daniel-sudz/pie/docs/Oscilloscope Music 7a3aaad3ab964c1fb35f99a9dc6e4d58/Mechanical Design b92b71b563af48b09839214c2a25bd87/Keyboard Laser Files bfc2a2a59c6f4edcae71e7054d06419a.html

# Keyboard Laser Files

All of these files were cut from 4.9mm thick plywood, except the Top, which was cut from 3.2mm plywood.

Back.dxf

Bottom.dxf

Front.dxf

Left.dxf

Right.dxf

Switch Back.dxf

Switch Left.dxf

Switch Plate.dxf

Top.dxf

The keyboard also includes two 3D printed parts:

Black key.stl

Bracket.stl

You can view the original CAD document for yourself here: https://cad.onshape.com/documents/308a798550238d0f1d9b5cc9/w/01307690bded43323ab41f7d/e/85378917edef5c38c061a6b5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
