daniel-sudz/pie/docs/Oscilloscope Music 7a3aaad3ab964c1fb35f99a9dc6e4d58/Untitled 3.jpeg

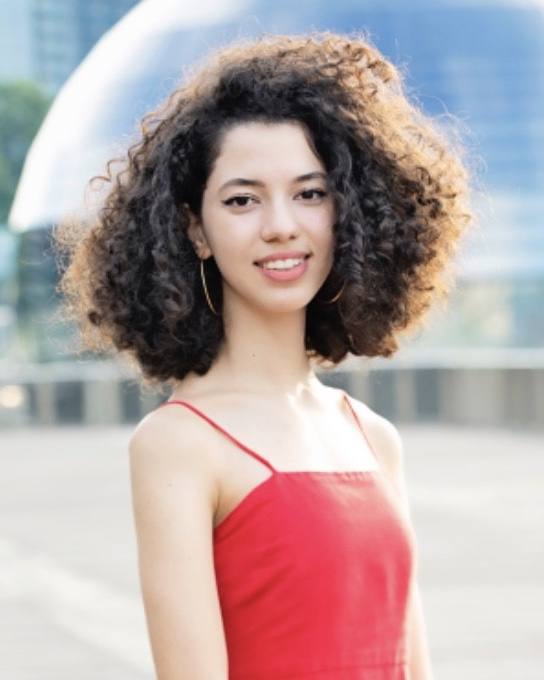
docs/Oscilloscope Music 7a3aaad3ab964c1fb35f99a9dc6e4d58/Untitled 3.jpeg
