daniel-sudz/pie/docs/Oscilloscope Music 7a3aaad3ab964c1fb35f99a9dc6e4d58/Mechanical Design b92b71b563af48b09839214c2a25bd87/Keyboard Laser Files bfc2a2a59c6f4edcae71e7054d06419a/Black_key.stl

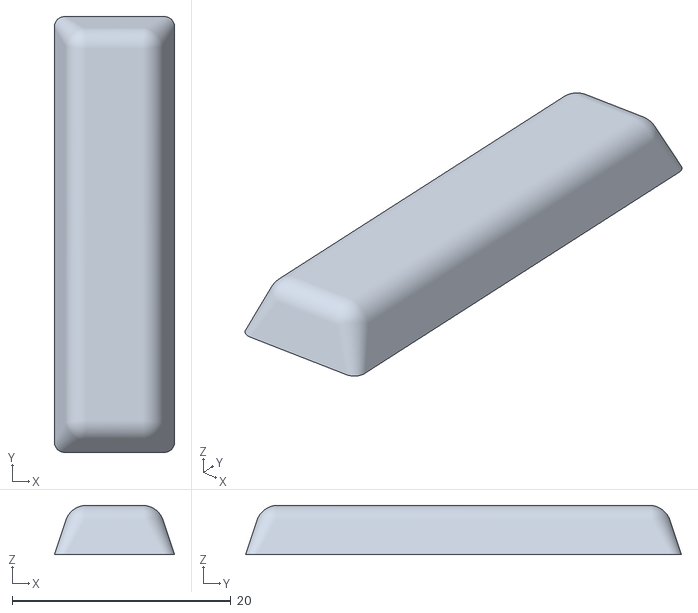
[picture p24: CAD file, 2023-12-13]
docs/Oscilloscope Music 7a3aaad3ab964c1fb35f99a9dc6e4d58/Mechanical Design b92b71b563af48b09839214c2a25bd87/Keyboard Laser Files bfc2a2a59c6f4edcae71e7054d06419a/Black_key.stl
11.0 x 39.8 x 4.50
