daniel-sudz/pie/miniprojects/miniproject2/calibration.txt

8, 501.38
12, 377.31
16, 292.92
20, 240.06
24, 197.93
28, 173.32
32, 150.78
36, 149.56
