daniel-sudz/pie/miniprojects/miniproject2/scans/ring-test.txt

70,60,300
70,61,300
70,62,300
70,63,300
70,64,300
70,65,300
70,66,300
70,67,300
70,68,300
70,69,300
70,70,300
70,71,300
70,72,300
70,73,300
70,74,300
70,75,300
70,76,300
70,77,300
70,78,300
70,79,300
70,80,300
70,81,300
70,82,300
70,83,300
70,84,300
70,85,300
70,86,300
70,87,300
70,88,300
70,89,300
70,90,300
70,91,300
70,92,300
70,93,300
70,94,300
70,95,300
70,96,300
70,97,300
70,98,300
70,99,300
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
