daniel-sudz/pie/(commit log)

2023-09-14 fix encoding to ascii
    [main.cpp, server.py]
2023-09-14 proccess carriage return
2023-09-15 improved calibration
2023-09-15 add calibration vis
2023-09-15 add labels to calibration plot
2023-09-16 increase delay on servo
2023-09-18 implement sensor spike filtering
2023-09-18 got a new sensor
2023-09-28 add pid template
2023-10-02 update pid stuff
2023-10-02 update pid
2023-10-09 add pid constants tuning to python side
2023-10-09 add two new sensors
2023-10-23 move to arduino
2023-10-23 Add header files for arduino wavetable synth
2023-11-12 Serial (#5)
    * get sdl2
    * added SDL2 shell code
    * something is displaying
    * add format file
    * start serial class
    * temp
    * add boost
    * something from serial
    * serial works :)
    * async timers ok
    * changes from last time
    * refactor
    * add port audio dependency
    * start portaudio implementation
    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
2023-11-13 Arduino code component for etch-a-sketch (#10)
    * Arduino code component for etch-a-sketch
    * Delete arduino/src/main.cpp
    * Rename etchasketch.cpp to main.cpp
    ---------
2023-11-30 parameterize tracing by frequency (#16)
    * parameterize tracing by frequency
    * fix zero pot value edge case
    * typo
2023-12-07 handle case where no note is being pressed (#21)
2023-12-07 various bug fixes (#23)
    * demo
    * remove old debug info
    * change log message
    [main.cpp]
2023-12-07 jank filter patch for bug (#24)
2023-12-08 Added polyphony and debounce to Arduino firmware. Removed unused header files.
2023-12-08 Added reset button and sustain pedal
2023-12-08 Fixed inverted footpedal. Apparently footpedals are NC.
    [main.cpp]
2023-12-09 full polyphony support (#32)
    * change serial printing format
    * polyphony start
    * polyphony start
    * make bitfields work
    * update etch a sketch to support bit fields
    * add a hard reset
    * add loop file
    [main.cpp]
2023-12-13 add final site (#42)
    [Back.dxf, Black_key.stl, Bottom.dxf, Bracket.stl, Front.dxf, Left.dxf, Right.dxf, Switch_Back.dxf]
